viniciuslevi/neorv32/docs/tcc/FPGA AI Suite Analysis.md

# FPGA AI Suite Analysis - Análise e Limitações

> **Análise da "Altera FPGA AI Suite" vs. Realidade do Cyclone IV**

---

## 📋 Visão Geral

A ferramenta **Altera FPGA AI Suite** (versões 2023.1.1 e posteriores) é poderosa, mas sua aplicação no Cyclone IV possui restrições críticas que precisam ser compreendidas para o sucesso do TCC.

### 🔗 Links Relacionados
- [[Home]] - Página principal
- [[HLS Design Flow]] - Alternativa ao AI Suite
- [[DE2-115 Board]] - Especificações da placa

---

## 🛠️ Altera FPGA AI Suite

### O que é

A **FPGA AI Suite** é uma ferramenta da Intel/Altera que permite:
- Compilar modelos de machine learning para FPGAs
- Otimizar automaticamente a inferência
- Gerar IPs de aceleração de IA

### Versões Disponíveis

| Versão | Ano | Status |
|---|-----|---|
| 2023.1.1 | 2023 | Estável |
| 2024.x | 2024 | Atual |

---

## ⚠️ Limitações para o Cyclone IV

### Famílias de FPGA Suportadas

A documentação oficial indica que o suporte principal foca em famílias modernas de **alto desempenho**:

```
┌─────────────────────────────────────────────────────────────┐
│           FPGAs Suportados pelo AI Suite                     │
│                                                              │
│  ┌─────────────────────────────────────────────────────┐   │
│  │  Alto Desempenho (Suporte Completo)                 │   │
│  │                                                      │   │
│  │  • Agilex 7                                          │   │
│  │  • Agilex 5                                          │   │
│  │  • Agilex 3                                          │   │
│  │  • Stratix 10                                        │   │
│  │  • Arria 10                                          │   │
│  └─────────────────────────────────────────────────────┘   │
│                                                              │
│  ┌─────────────────────────────────────────────────────┐   │
│  │  Power & Cost-Optimized (Suporte Limitado)          │   │
│  │                                                      │   │
│  │  • Cyclone V    ⚠️ Parcial                          │   │
│  │  • Cyclone IV   ❌ Não suportado                     │   │
│  │  • Cyclone III  ❌ Não suportado                     │   │
│  └─────────────────────────────────────────────────────┘   │
│                                                              │
└─────────────────────────────────────────────────────────────┘
```

### Classificação do Cyclone IV

| Característica | Valor |
|---|---|
| **Família** | Power and Cost-Optimized |
| **Maturidade** | Mature (Legado) |
| **Tensor Blocks** | ❌ Não possui |
| **Unidades de Ponto Flutuante Endurecidas** | ❌ Não possui |
| **Suporte AI Suite** | ❌ Não compatível |

### Por que não funciona?

O Cyclone IV **não possui** os recursos de hardware especializados exigidos pelo fluxo automatizado do AI Suite:

1. **Tensor Blocks**: Unidades de multiplicação-acumulação (MAC) especializadas para IA
2. **Unidades de Ponto Flutuante**: Hardware dedicado para operações float32/float16
3. **Memória HBM**: Alta largura de banda para dados de IA

---

## 🔄 Alternativas para o Cyclone IV

### Abordagem Recomendada

O caminho mais viável e academicamente rico para este FPGA **não é o AI Suite**, mas sim:

```
┌─────────────────────────────────────────────────────────────┐
│           Fluxo de Design Alternativo                        │
│                                                              │
│  ┌──────────────┐    ┌──────────────┐    ┌──────────────┐  │
│  │   Python     │    │   HLS ou     │    │   VHDL/      │  │
│  │   (Treino)   │ ─▶ │   hls4ml     │ ─▶ │   Verilog    │  │
│  │              │    │              │    │              │  │
│  │ • Keras      │    │ • Conversão  │    │ • Síntese    │  │
│  │ • PyTorch    │    │ • Otimização │    │ • RTL        │  │
│  │ • TensorFlow │    │              │    │              │  │
│  └──────────────┘    └──────────────┘    └──────────────┘  │
│                                                              │
└─────────────────────────────────────────────────────────────┘
```

### 1. HLS (High-Level Synthesis)

#### Intel HLS Compiler

- **Descrição**: Compilador C++ para VHDL/Verilog
- **Vantagem**: Abstração de alto nível
- **Compatibilidade**: Funciona com Cyclone IV

#### hls4ml (Open Source)

- **Descrição**: Ferramenta open-source para converter modelos ML em HDL
- **Vantagem**: Especializado para machine learning
- **Compatibilidade**: Suporta FPGAs antigos

### 2. RTL Puro

- **Descrição**: Desenvolvimento direto em VHDL/Verilog
- **Vantagem**: Controle total do hardware
- **Desafio**: Maior complexidade

---

## 📊 Comparação de Abordagens

| Critério | AI Suite | HLS | RTL Puro |
|---|---|-----|---|
| **Suporte Cyclone IV** | ❌ | ✅ | ✅ |
| **Facilidade de uso** | Alta | Média | Baixa |
| **Controle do hardware** | Baixo | Médio | Alto |
| **Valor acadêmico** | Baixo | Alto | Muito Alto |
| **Tempo de desenvolvimento** | Curto | Médio | Longo |

---

## 🎯 Recomendação para o TCC

### Estratégia Recomendada

```
┌─────────────────────────────────────────────────────────────┐
│              Pipeline de Desenvolvimento                     │
│                                                              │
│  Fase 1: Treino do Modelo                                    │
│  ┌─────────────────────────────────────────────────────┐   │
│  │  Python + Keras/PyTorch                              │   │
│  │  • Definir arquitetura da rede                       │   │
│  │  • Treinar modelo                                    │   │
│  │  • Quantizar para INT8                               │   │
│  └─────────────────────────────────────────────────────┘   │
│                          │                                   │
│                          ▼                                   │
│  Fase 2: Conversão para Hardware                             │
│  ┌─────────────────────────────────────────────────────┐   │
│  │  hls4ml ou Intel HLS Compiler                        │   │
│  │  • Converter modelo treinado                         │   │
│  │  • Gerar código VHDL/Verilog                         │   │
│  │  • Otimizar para Cyclone IV                          │   │
│  └─────────────────────────────────────────────────────┘   │
│                          │                                   │
│                          ▼                                   │
│  Fase 3: Integração e Síntese                                │
│  ┌─────────────────────────────────────────────────────┐   │
│  │  Quartus Prime + Platform Designer                   │   │
│  │  • Integrar com NEORV32                              │   │
│  │  • Sintetizar para Cyclone IV                        │   │
│  │  • Otimizar timing                                   │   │
│  └─────────────────────────────────────────────────────┘   │
│                                                              │
└─────────────────────────────────────────────────────────────┘
```

### Justificativa

1. **Independência de ferramentas proprietárias**: Não depende do AI Suite
2. **Valor acadêmico**: Demonstra conhecimento profundo de hardware
3. **Flexibilidade**: Controle total sobre a implementação
4. **Portabilidade**: Conhecimento aplicável a outros FPGAs

---

## 🔧 Ferramentas Recomendadas

### Para Treino
- **TensorFlow/Keras**: API de alto nível
- **PyTorch**: Flexibilidade de pesquisa
- **Quantização**: TensorFlow Lite ou PyTorch Quantization

### Para Conversão
- **hls4ml**: Especializado para ML em FPGA
- **Intel HLS Compiler**: Integração com Quartus
- **Vitis HLS**: Alternativa open-source

### Para Síntese
- **Quartus Prime**: Ferramenta oficial Intel
- **Platform Designer (Qsys)**: Integração de IPs

---

## 📚 Referências

- [Intel FPGA AI Suite Documentation](https://www.intel.com/content/www/us/en/docs/programmable/683948/current/overview.html)
- [hls4ml Documentation](https://fastmachinelearning.org/hls4ml/)
- [Intel HLS Compiler User Guide](https://www.intel.com/content/www/us/en/docs/programmable/683623/current/overview.html)

---

## 🏷️ Tags

#AISuite #CycloneIV #HLS #hls4ml #Limitations #AlternativeApproach #Intel #Quartus

---

**Veja também:**
- [[HLS Design Flow]] - Fluxo de design usando HLS
- [[Systolic Array]] - Arquitetura do acelerador
- [[Implementation Matrix]] - Visão geral da implementação
