viniciuslevi/neorv32/rtl/core/neorv32_bootrom_image.vhd

library ieee;
use ieee.std_logic_1164.all;

package neorv32_bootrom_image is

type rom_t is array (0 to 1023) of std_ulogic_vector(31 downto 0);
constant image_size_c : natural := 3960;
constant image_data_c : rom_t := (
x"f14020f3",
x"80200217",
x"0fb20213",
x"ff027113",
x"80200197",
x"7f018193",
x"000022b7",
x"80028293",
x"30029073",
x"00000317",
x"0ec30313",
x"30531073",
x"30401073",
x"00001397",
x"f4438393",
x"80200417",
x"fc440413",
x"80200497",
x"fbc48493",
x"80200517",
x"fb450513",
x"80200597",
x"fb858593",
x"00000613",
x"00000693",
x"00000713",
x"00000793",
x"04008263",
x"00000797",
x"01c78793",
x"30579073",
x"30445073",
x"30046073",
x"10500073",
x"ffdff06f",
x"00000797",
x"08478793",
x"30579073",
x"fff44737",
x"00872103",
x"00c72603",
x"fff40737",
x"00072223",
x"0380006f",
x"00838e63",
x"00945c63",
x"0003a783",
x"00f42023",
x"00438393",
x"00440413",
x"fedff06f",
x"00b55863",
x"00052023",
x"00450513",
x"ff5ff06f",
x"00000617",
x"7cc60613",
x"0ff0000f",
x"0000100f",
x"00000513",
x"00000593",
x"000600e7",
x"30047073",
x"30401073",
x"00000597",
x"01058593",
x"30559073",
x"34051073",
x"10500073",
x"ffdff06f",
x"00000513",
x"00008067",
x"fff507b7",
x"0007a703",
x"00f71693",
x"fe06dce3",
x"0047a503",
x"0ff57513",
x"00008067",
x"ff010113",
x"00812423",
x"00912223",
x"00112623",
x"00050493",
x"00000413",
x"fcdff0ef",
x"00440793",
x"002787b3",
x"fea78e23",
x"00140413",
x"00400793",
x"fef414e3",
x"00012783",
x"00c12083",
x"00812403",
x"00f4a023",
x"00000513",
x"00412483",
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
x"00000020",
x"6d305b1b",
x"0000000a",
x"65206f4e",
x"75636578",
x"6c626174",
x"42202e65",
x"20746f6f",
x"77796e61",
x"203f7961",
x"6e2f7928",
x"00000a29",
x"746f6f42",
x"20676e69",
x"6d6f7266",
x"00000020",
x"0a2e2e2e",
x"0000000a",
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
others => (others => '0')
);

end neorv32_bootrom_image;
