viniciuslevi/neorv32/sw/tcc/mnist_infer/sdram.c

// ================================================================================ //
// NEORV32 MNIST Inference (Fase 3/4 do TCC) - Acesso a SDRAM e carga via UART      //
// ================================================================================ //
#include "sdram.h"
#include "lcd.h"
#include <neorv32.h>

#define BLOB_CHUNK_SIZE  64
#define BLOB_BYTE_TIMEOUT_MS 200

// A SDRAM as vezes deixa de responder (ack) dentro do XBUS_TIMEOUT em
// acessos isolados -- confirmado via neorv32_rte_setup(): "Store/Load
// access fault" real, nao um travamento infinito da FSM. A causa exata
// ainda nao foi isolada (parece uma condicao de borda rara, possivelmente
// envolvendo o timer de refresh), mas o efeito e transitorio: a MESMA
// instrucao, se repetida, normalmente sucede logo em seguida. O handler
// padrao do RTE avanca MEPC e PULA a instrucao que falhou (perdendo o
// dado); aqui, em vez disso, forcamos um retry recuando MEPC de volta,
// com um limite pra nao travar de verdade se a falha for persistente.
#define SDRAM_FAULT_MAX_CONSECUTIVE_RETRIES 64  // 100000 nao distinguia transitorio de quebrado

static volatile uint32_t sdram_fault_last_mepc = 0;
static volatile uint32_t sdram_fault_last_addr = 0;
static volatile uint32_t sdram_fault_retry_count = 0;
static volatile uint32_t sdram_fault_total = 0;
static volatile uint32_t sdram_fault_giveups = 0;

static void sdram_access_fault_retry_handler(void) {
    uint32_t mepc = neorv32_cpu_csr_read(CSR_MEPC);
    uint32_t addr = neorv32_cpu_csr_read(CSR_MTVAL); // endereco do acesso que falhou

    // "Consecutiva" = mesma instrucao E mesmo endereco, ou seja, a repeticao do
    // proprio retry. So a instrucao nao basta: num laco quente a mesma load roda
    // milhoes de vezes, e falhas isoladas em iteracoes diferentes somavam ate o
    // limite -- a partir dai toda falha naquela instrucao era pulada e o
    // registrador ficava com valor velho (corrompeu a inferencia so em software).
    if (mepc == sdram_fault_last_mepc && addr == sdram_fault_last_addr) {
        sdram_fault_retry_count++;
    } else {
        sdram_fault_last_mepc = mepc;
        sdram_fault_last_addr = addr;
        sdram_fault_retry_count = 1;
    }
    sdram_fault_total++;

    if (sdram_fault_retry_count > SDRAM_FAULT_MAX_CONSECUTIVE_RETRIES) {
        // falha persistente de verdade (nao transitoria): desiste e deixa o
        // framework avancar o MEPC normalmente, para nao travar para sempre.
        // O dado se perde: contado a parte para nao passar despercebido.
        sdram_fault_giveups++;
        sdram_fault_retry_count = 0;
        return;
    }

    // forca retry: recua MEPC para compensar o +4/+2 que o framework do RTE
    // aplica automaticamente depois que este handler retornar
    uint32_t mtinst = neorv32_cpu_csr_read(CSR_MTINST);
    int compressed = ((mtinst & 3) != 3);
    neorv32_cpu_csr_write(CSR_MEPC, mepc - (compressed ? 2 : 4));
}

void sdram_install_fault_retry_handler(void) {
    neorv32_rte_handler_install(TRAP_CODE_L_ACCESS, sdram_access_fault_retry_handler);
    neorv32_rte_handler_install(TRAP_CODE_S_ACCESS, sdram_access_fault_retry_handler);
}

uint32_t sdram_get_fault_count(void) {
    return sdram_fault_total;
}

uint32_t sdram_get_fault_giveups(void) {
    return sdram_fault_giveups;
}

// Le um byte com timeout limitado (-1 se nada chegar a tempo). Alguns
// adaptadores USB-serial baratos (ex.: CH340) derrubam bytes esporadicamente
// em transferencias longas -- sem timeout, um byte perdido trava o firmware
// para sempre esperando por ele, sem chance do host perceber e reenviar.
static int uart0_getc_timeout(uint32_t timeout_ms) {
    uint32_t clk = neorv32_sysinfo_get_clk();
    for (uint32_t waited = 0; waited < timeout_ms; waited++) {
        if (neorv32_uart0_char_received()) {
            return (uint8_t)neorv32_uart0_char_received_get();
        }
        neorv32_aux_delay_ms(clk, 1);
    }
    return -1;
}

// Descarta qualquer byte que ainda chegue por ~50ms. Usado apos uma falha de
// pedaco: os bytes "atrasados" do pedaco que acabou de falhar podem ainda
// estar a caminho, e se nao forem descartados aqui, se misturam com o
// reenvio do host e dessincronizam o protocolo permanentemente (toda
// tentativa seguinte falharia tambem, nao so essa).
static void uart0_drain(void) {
    uint32_t clk = neorv32_sysinfo_get_clk();
    uint32_t idle_ms = 0;
    while (idle_ms < 50) {
        if (neorv32_uart0_char_received()) {
            (void)neorv32_uart0_char_received_get();
            idle_ms = 0;
        } else {
            neorv32_aux_delay_ms(clk, 1);
            idle_ms++;
        }
    }
}

// Recebe o blob em pedacos pequenos, cada um confirmado individualmente
// ('K'=ok, avanca / 'N'=falhou, host deve reenviar o mesmo pedaco). Ver
// tools/send_weights.py para o lado host do protocolo.
uint32_t sdram_uart_recv_blob(uint32_t sdram_offset) {
    uint32_t len = 0;
    for (int i = 0; i < 4; i++) {
        uint32_t b = (uint8_t)neorv32_uart0_getc();
        len |= (b << (8 * i));
    }

    volatile uint8_t *dst = (volatile uint8_t*)(SDRAM_BASE + sdram_offset);
    uint32_t received = 0;
    while (received < len) {
        uint32_t want = len - received;
        if (want > BLOB_CHUNK_SIZE) {
            want = BLOB_CHUNK_SIZE;
        }
        uint8_t buf[BLOB_CHUNK_SIZE];
        int ok = 1;
        for (uint32_t i = 0; i < want; i++) {
            int c = uart0_getc_timeout(BLOB_BYTE_TIMEOUT_MS);
            if (c < 0) {
                ok = 0;
                break;
            }
            buf[i] = (uint8_t)c;
        }

        if (ok) {
            for (uint32_t i = 0; i < want; i++) {
                dst[received + i] = buf[i];
            }
            received += want;
            neorv32_uart0_putc('K');
        } else {
            uart0_drain(); // descarta bytes atrasados do pedaco que falhou
            neorv32_uart0_putc('N'); // host reenvia este mesmo pedaco
        }
    }

    // ack: devolve o tamanho recebido (4 bytes little-endian) para o host confirmar
    for (int i = 0; i < 4; i++) {
        neorv32_uart0_putc((char)((len >> (8 * i)) & 0xFF));
    }

    return len;
}

char sdram_uart_handshake_loop(void) {
    while (1) {
        // re-send 'R' periodically instead of blocking on it once: a host
        // script that connects a moment late would otherwise miss the only
        // 'R' ever sent and hang forever waiting for a command
        // Poll every 1ms (not a single 300ms sleep): a long blind window
        // between checks lets the host's very next bytes (cmd+len+first
        // chunk) overrun the small RX FIFO before we ever look at it.
        neorv32_uart0_putc('R'); // ready
        uint32_t waited_ms = 0;
        while (!neorv32_uart0_char_received()) {
            neorv32_aux_delay_ms(neorv32_sysinfo_get_clk(), 1);
            if (++waited_ms >= 300) {
                neorv32_uart0_putc('R');
                waited_ms = 0;
            }
        }
        char cmd = neorv32_uart0_char_received_get();
        if (cmd == 'W') {
            lcd_clear();
            lcd_goto(0, 0); lcd_puts("Recebendo pesos");
            lcd_goto(1, 0); lcd_puts("422 KB via UART");
            uint32_t n = sdram_uart_recv_blob(SDRAM_OFF_WEIGHTS);
            lcd_clear();
            lcd_goto(0, 0); lcd_puts("Pesos na SDRAM");
            lcd_goto(1, 0); lcd_puti((int32_t)n); lcd_puts(" bytes");
            neorv32_uart0_printf("\n[sdram] pesos recebidos: %u bytes\n", n);
        } else if (cmd == 'I') {
            lcd_clear();
            lcd_goto(0, 0); lcd_puts("Recebendo imagem");
            uint32_t n = sdram_uart_recv_blob(SDRAM_OFF_INPUT);
            lcd_clear();
            lcd_goto(0, 0); lcd_puts("Imagem recebida");
            lcd_goto(1, 0); lcd_puti((int32_t)n); lcd_puts(" bytes");
            neorv32_uart0_printf("\n[sdram] imagem recebida: %u bytes\n", n);
        } else if (cmd == 'G' || cmd == 'H' || cmd == 'S') {
            return cmd;
        }
    }
}
