viniciuslevi/neorv32/(commit log)

2026-08-20 Add 8x8 systolic array AI accelerator for DE2-115 (TCC project)
    Adds a weight-stationary INT8 systolic array accelerator (PE grid,
    array, Wishbone/XBUS interface, standalone LED test, CFS legacy
    variant) integrated into a full DE2-115 SoC with SDRAM controller,
    plus GHDL testbenches, Quartus projects, firmware examples, and
    project documentation.
    Includes the fixes needed to bring the design up on real hardware:
    - systolic array weight_i port updated to a full weight-stationary
    tile across all consumers (top, CFS variant, standalone test)
    - wb_accelerator: start bit was level-triggered instead of edge-
    triggered, causing the compute FSM to auto-retrigger forever
    - bootloader uart_getc()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
    [accel_driver.c, accel_driver.h, inference.c, inference.h, main.c, neorv32_bootrom_image.vhd, neorv32_systolic_accelator.vhd, neorv32_systolic_standalone_test.vhd]
2026-08-20 Robustify neorv32_mnist_infer UART weight-load protocol
    Fixes found while attempting the first end-to-end MNIST inference on
    real hardware over the CH340 USB-serial adapter:
    - sdram.c: the 'R' (ready) handshake byte was sent only once before
    blocking on a command; a host script connecting a moment late would
    miss it and hang forever. Now resent periodically while polling
    (finely, not via one long sleep, to avoid a blind window that lets
    the RX FIFO overrun).
    - sdram.c: sdram_uart_recv_blob() now reads the blob in small chunks,
    each acknowledged ('K') or rejected ('N', with a bounded per-byte
    receive timeout) individually, and drains stray in-flight bytes
    after a rejected chunk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
    [main.c, sdram.c, send_weights.py]
2026-08-20 Fix SDRAM DRAM_CLK generation and add access-fault retry; first MNIST inference on real hardware
    Root-caused and fixed why the SDRAM interface was unreliable on real
    DE2-115 hardware despite passing GHDL simulation with an ideal model:
    - DRAM_CLK was driven by a plain inverter (not clk_i) with no dedicated
    clock buffer/PLL, leaving its real phase at the mercy of generic FPGA
    routing delay. Replaced with a PLL (ALTPLL, -3ns phase shift),
    generated via `qmegawiz -silent` since the Quartus IP Catalog GUI
    hangs in this environment (missing libpng12/libccl_*/libQtCore
    libraries that only exist inside the Quartus install tree). SDRAM
    controller reset is now held until the PLL locks.
    -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
    [main.c, sdram.c, sdram.h, send_weights.py]
2026-09-29 Hold the result on the LCD until KEY[1], and show every stage
    The predicted class was unreadable: the loop went straight back to the
    handshake and cleared the display before anyone could read it. It now
    waits for a KEY[1] click, so the result stays up until the operator asks
    for the next image.
    KEY[1] was wired to a pin and labelled "livre" but connected to nothing --
    the NEORV32 GPIO input port was not hooked up in the top level at all.
    Connect it to gpio_i(0), inverted there since the DE2-115 buttons are
    active low, so '1' means pressed in firmware. The wait needs a full click
    (press and release) with 20ms of debounce.
    The LCD now follows the whole flow rather than just the endpoints: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
    [inference.c, main.c, sdram.c]
2026-09-29 Add Windows build and UART upload path for neorv32_mnist_infer
    The existing flow assumed a POSIX host. Two things blocked it on Windows:
    - uart_upload.sh needs bash plus a working `stty`. The MSYS/Git-Bash `stty`
    cannot configure Windows COM ports -- it fails on `raw` and `cread`, and
    the script aborts under `set -e` before sending a single byte. Added
    sw/image_gen/uart_upload.py, which speaks the same bootloader protocol
    (" u", 16-byte throttled chunks at 19200 baud, wait for "OK", then "e")
    but only needs pyserial. New `upload_py` target uses it; `upload` and
    common.mk are untouched, so the POSIX flow is unchanged.
    - image_gen.c includes <elf.h>, which MinGW does not ship. Ad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
    [uart_upload.py]
2026-09-29 Drive DRAM_CLK from the PLL and constrain the SDRAM interface
    SDRAM diagnostics now pass completely: 0 errors in 5120 words across four
    offsets and five patterns, including address-as-data, which had never passed.
    Two things were wrong.
    DRAM_CLK never came from the PLL. 27b6f5f3 describes replacing the plain
    inverter with a phase-shifted PLL, but left c0 => open and kept
    `dram_clk_o <= not clk_i`, marked "DIAGNOSTICO TEMPORARIO". The PLL existed
    only for its locked signal, so the configured phase was never in effect and
    the chip's clock came from combinational logic routed generically to the pin
    -- exactly what the change meant to eliminate. Connect c0 to dram_clk_o at
    180 degrees (-10000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
2026-09-29 Fix accelerator start edge and expose operation-level done
    End-to-end MNIST inference now matches the reference exactly: logits
    -20 -15 18 17 -12 -21 -96 87 -1 24 and class 7, identical to
    out/expected.txt. The SW-vs-HW benchmark reports identical results where
    it previously reported all 64 elements divergent.
    Two independent defects, both making the accelerator useless after its
    first operation.
    The start never produced an edge. The wrapper FSM triggers on a rising
    edge of CTRL[0], not the level, but the driver wrote 0x1 and never
    returned to zero. Only the first operation after reset ever started; from
    the second on the array stayed idle, and since done was still set from the
    previous ru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
    [accel_driver.c, inference.c, sdram.c]
2026-09-29 Show inference state and predicted class on the DE2-115 LCD
    Adds an HD44780 driver (lcd.c) bit-banged over GPIO, so the board reports
    without a serial terminal attached -- the point being a live demo.
    boot NEORV32 + MNIST / testando SDRAM
    idle Aguardando / imagem via UART
    running Inferindo...
    result Classe prevista:/ 7
    GPIO goes from 8 to 32 pins. The green LEDs keep gpio[7:0] unchanged; the
    LCD takes gpio[15:8] for data, gpio[16] for RS and gpio[17] for EN. RW is
    tied low and ON/BLON tied high in the top level, so only ten GPIO bits are
    actually driven.
    Two implementation notes. RW tied low means the busy flag cannot be read,
    so the driver uses d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
2026-09-30 Bring the bring-up diary and run guide in line with the hardware debug record
    The diary and guide existed only on the pre-sync branch and described the
    first session's conclusions, several of which the second session disproved:
    the SDRAM corruption was an unregistered Wishbone address, not a physical
    defect on chip 0; the PLL output was never connected to DRAM_CLK; and the
    benchmark divergence came from the accelerator start/done interface, not
    SDRAM load or heat. Wrong conclusions are kept and marked as revised, with a
    retrospective of which evidence misled and why.
    The guide now reflects the two UART speeds (bootloader 19200, application
    115200), the Windows upload path, the SDRAM diagnos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
2026-09-30 Raise the application UART to 115200 and restore the speedup line
    The 422KB weight transfer ran at 19200 baud, about 220 seconds. The
    application's UART is independent of the bootloader's, which stays at 19200
    in the bitstream and only carries the ~16KB firmware, so the application can
    be raised on a firmware rebuild alone. At 115200 the transfer drops to
    roughly 40 seconds. Nothing throttles it: the protocol acks every 64 bytes
    and the RX FIFO holds 64, so throughput is self-limiting. send_weights.py
    already took --baud, which is now required.
    The speedup line is back, and the hang it caused is understood rather than
    avoided. It read:
    (uint32_t)(((uint64_t)(cyc_sw % cyc_hw) * 100u) / cy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
    [inference.c, main.c, uart_upload.py]
2026-11-01 Key SDRAM fault retries on the faulting address, and count give-ups
    The retry handler treated two faults as consecutive when they came from the
    same instruction. In a hot loop the same load runs millions of times, so
    isolated faults on different iterations kept adding up until they passed
    SDRAM_FAULT_MAX_CONSECUTIVE_RETRIES. From then on every fault on that
    instruction was skipped, and the destination register kept a stale value.
    This is what corrupted the software-only inference.
    A fault is now consecutive only when both mepc and mtval match, which means
    it is the retry of the same access repeating. When the handler does give
    up, the data from that access is lost, so it resets the streak a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
    [sdram.c, sdram.h]
2026-11-01 Add a CPU-only inference path to compare against the accelerator
    bench_sw_vs_hw measured a single 8x8x8 tile, which says little about the
    whole network, where im2col, requantization and pooling run on the CPU
    either way. run_inference now takes use_accel, and with it set to 0 every
    matmul goes through sw_matmul_i8. That function has the same semantics and
    layout as accel_matmul_i8, including the -zp_a * colsum(W) correction.
    Integer addition is associative, so the logits must match bit for bit.
    Two new handshake commands:
    'H' like 'G' but does not wait for KEY1, for batch collection by the host
    'S' like 'H', then repeats the inference on the CPU, compares the logits
    and prints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
    [inference.c, inference.h, main.c, sdram.c, sdram.h]
2026-11-01 Add the SDC, CFS and PLL .cmp files to the Quartus project
    Quartus 25.1 rewrote the .qsf. Most of the diff is reordering: the LCD pin
    block moved above the file list, and the file lost its trailing newline.
    Three files joined the project: neorv32_mnist_accel.sdc,
    neorv32_cfs.vhd and sdram_clk_pll_core.cmp. All three were already
    tracked. Adding the SDC matters most, because builds now get its timing
    constraints applied.
2026-11-07 Add accelerator DMA path and SoC simulation (session 3, simulation only)
    - SDRAM controller now latches a request in any state when none is
    pending: the XBUS strobe lasts one cycle, so requests arriving during
    AUTO REFRESH were lost and turned into access faults (found in
    simulation, not yet confirmed on the board)
    - Accelerator DMA path and driver (accel_matmul_dma), accel_dma_test
    firmware, full-SoC testbench with PLL simulation model and scripts
    - Testbenches updated to drive single-cycle strobes like the XBUS
    - Bring-up diary: session 3 notes
2026-11-14 Move the session 3 changes out of the TCC branch
    Reverts 3eb1cbff (accelerator DMA path, SDRAM request latch fix, SoC
    testbench and accel_dma_test firmware). None of it was tested on the
    board, and the TCC results were all measured without it. The hardware
    and firmware here match the versions used in the measurements again;
    the session 3 work lives on in the tcc-dma-experimental branch.
    The bring-up diary keeps the session 3 notes.
    [accel_driver.c, accel_driver.h, inference.c, inference.h, main.c, sdram.c, sdram.h, send_weights.py]
2026-11-14 Rename the TCC VHDL entities to the tcc_ prefix
    The entities now match their file names (tcc_systolic_pe.vhd declares
    tcc_systolic_pe, and so on). Updates the instantiations, testbenches,
    simulation script, the Quartus top-level entity and the legacy files
    that instantiate the systolic array. TCC.md and the simulation README
    describe the new convention and point to the tcc-dma-experimental
    branch for the session 3 work; the bring-up diary notes the same.
